DrCampy/FencingTester/Calculs.xlsx

Sheet: Iref_tlc59116
CM | 0
HC | 1
D5 | 1
D4 | 1
D3 | 1
D2 | 0
D1 | 0
D0 | 1
D | 57
VG | 0.9453125
Vout | 1.19109375
Rext | 660
Iref | 1.8046875
Iout, target | 9.0234375

Sheet: ATMega I2C SCL_Freq
Prescaler | 1 |  | CPU_Freq | 16000000
1
4
16 |  |  | SCL_Freq | 98765.4321
64
TWBR0 | 1 | TWBR | 73
TWBR1 | 0
TWBR2 | 0
TWBR3 | 1
TWBR4 | 0
TWBR5 | 0
TWBR6 | 1
TWBR7 | 0
