DrCampy/FencingTester/Illustrator/couvercle.pdf

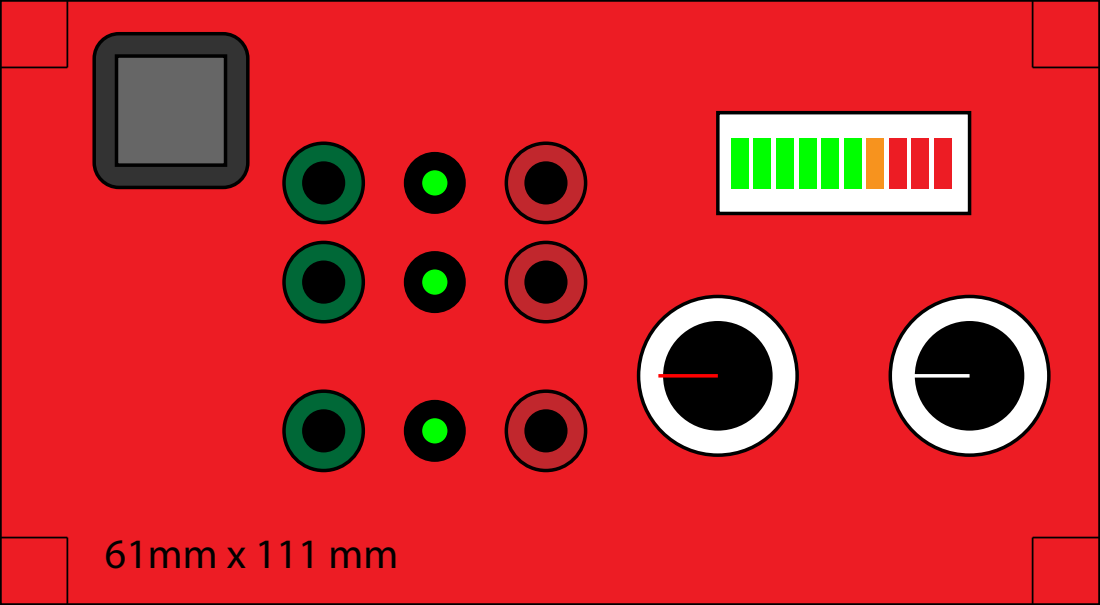
[picture p1: page 1]
