DrCampy/FencingTester/LTSpice - Simulations/alim.asc

C1: cap; 10µ
D1: schottky; MBR0530L
M1: nmos; rq5E035bn
M2: pmos; Si3421DV
R1: res; 10k
R2: res; 2k
R3: res; 5k
V1: voltage; PULSE(0 5 2 0.01 0.01 2 4.02 4)
V2: voltage; 3.2
Named nets: 0
.lib "D:\\Users\\Morgan Diepart\\Documents\\GitHub\\FencingTester\\LTSpice - Simulations\\rq5E035bn.lib"
.lib "D:\\Users\\Morgan Diepart\\Documents\\GitHub\\FencingTester\\LTSpice - Simulations\\Si3421DV_PS.LIB"
.tran 10
