DrCampy/FencingTester/LTSpice - Simulations/bargraph-bjt.asc

D1: LED; NSPW500BS
D2: schottky; MBR0530L
D3: schottky; MBR0530L
D4: schottky; MBR0530L
D5: schottky; MBR0530L
D6: schottky; MBR0530L
D7: schottky; MBR0530L
D8: schottky; MBR0530L
D9: schottky; MBR0530L
D10: schottky; MBR0530L
D11: LED; NSPW500BS
D12: LED; NSPW500BS
D13: LED; NSPW500BS
D14: LED; NSPW500BS
D15: LED; NSPW500BS
D21: LED; NSPW500BS
D22: LED; NSPW500BS
D23: LED; NSPW500BS
D24: LED; NSPW500BS
D25: LED; NSPW500BS
Q1: npn; BC817-25
Q2: npn; BC817-25
Q3: npn; BC817-25
Q4: npn; BC817-25
Q5: npn; BC817-25
Q6: npn; BC817-25
Q7: npn; BC817-25
Q8: npn; BC817-25
Q9: npn; BC817-25
Q10: npn; BC817-25
R1: res; 330
R2: res; 330
R3: res; 330
R4: res; 330
R5: res; 330
R6: res; 330
R7: res; 330
R8: res; 330
R9: res; 330
R10: res; 330
R11: res; 330
V1: voltage; 5
Named nets: 5V, 0
.tran 1
