DrCampy/FencingTester/LTSpice - Simulations/bargraph-mosfet.asc

D21: LED; NSPW500BS
D22: schottky; MBR0530L
D23: LED; NSPW500BS
D24: schottky; MBR0530L
D25: LED; NSPW500BS
D26: schottky; MBR0530L
D27: LED; NSPW500BS
D28: schottky; MBR0530L
D29: LED; NSPW500BS
D30: schottky; MBR0530L
D31: LED; NSPW500BS
D32: schottky; MBR0530L
D33: LED; NSPW500BS
D34: schottky; MBR0530L
D35: LED; NSPW500BS
D36: schottky; MBR0530L
D37: LED; NSPW500BS
D38: schottky; MBR0530L
D39: LED; NSPW500BS
D41: LED; NSPW500BS
M11: nmos; rq5E035bn
M12: nmos; rq5E035bn
M13: nmos; rq5E035bn
M14: nmos; rq5E035bn
M15: nmos; rq5E035bn
M16: nmos; rq5E035bn
M17: nmos; rq5E035bn
M18: nmos; rq5E035bn
M19: nmos; rq5E035bn
M20: nmos; rq5E035bn
R1: res; 20k
R2: res; 20k
R3: res; 20k
R4: res; 20k
R5: res; 20k
R6: res; 20k
R7: res; 20k
R8: res; 20k
R9: res; 20k
R10: res; 20k
R12: res; 330
R13: res; 330
R14: res; 330
R15: res; 330
R16: res; 330
R17: res; 330
R18: res; 330
R19: res; 330
R20: res; 330
R21: res; 330
R22: res; 330
V1: voltage; 4.7
Named nets: 5V, 0
.lib "D:\\Users\\Morgan Diepart\\Documents\\GitHub\\FencingTester\\LTSpice - Simulations\\rq5E035bn.lib"
.tran 15
