DrCampy/FencingTester/KiCad/FencingTester.kicad_pcb

## KiCad design KiCad/FencingTester.kicad_pcb (2019-10-11)

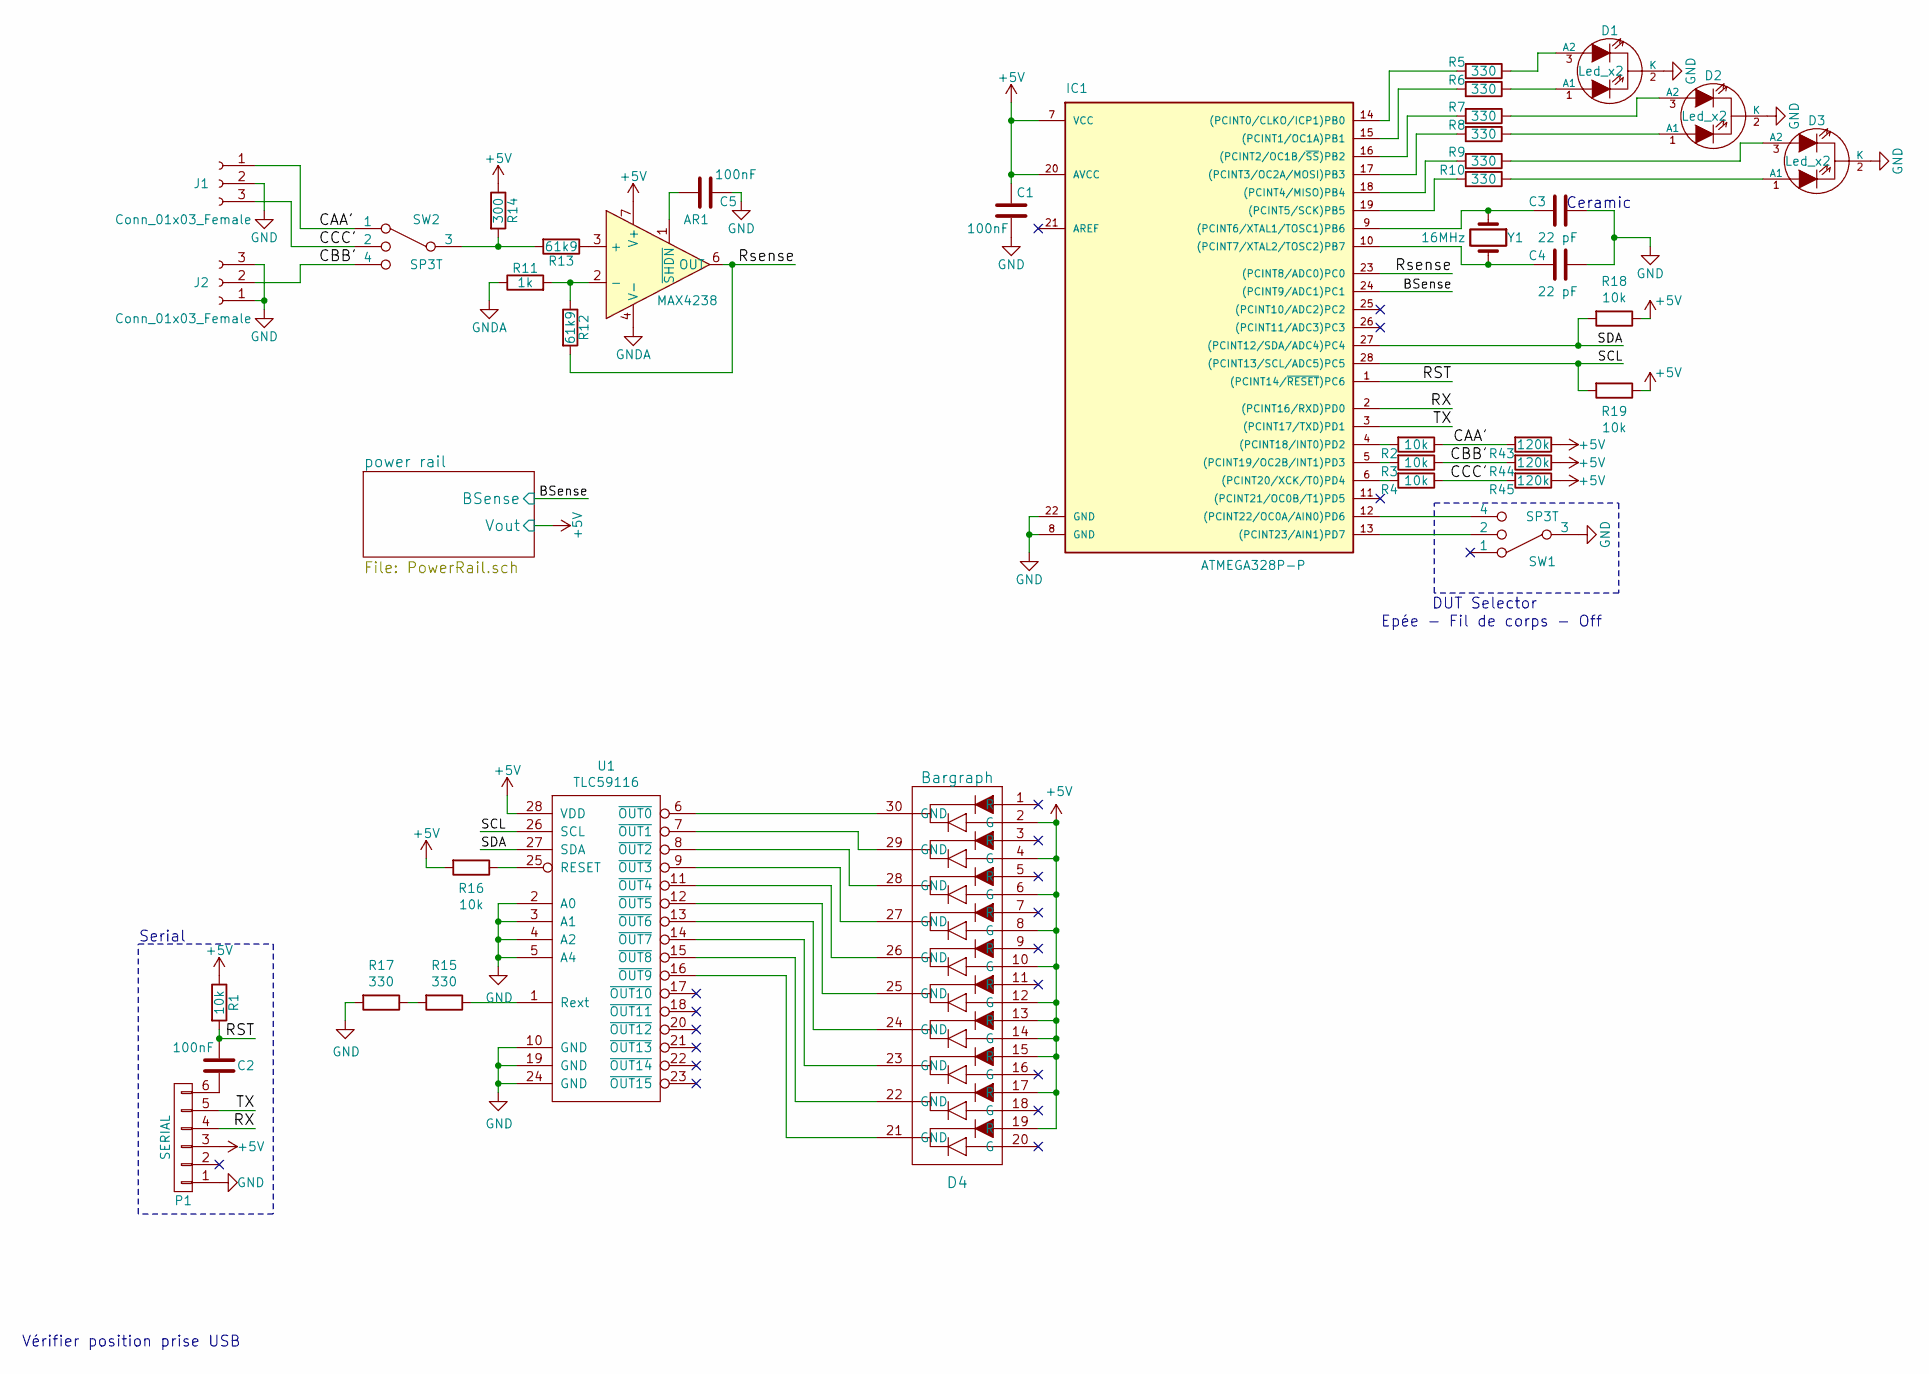
[picture p2: schematic FencingTester.sch, Fencing Tester]

Parts:
AR1: MAX4238; SOIC-8_3.9x4.9mm_P1.27mm
C1, C2, C5: 100nF; C_0805_2012Metric_Pad1.15x1.40mm_HandSolder
C3, C4: 22 pF; C_0805_2012Metric_Pad1.15x1.40mm_HandSolder
D1, D2, D3: Led_x2; 3PadsWires
D4: Bargraph
IC1: ATMEGA328P-P; DIP-28_W7.62mm_Socket_LongPads
J1, J2: Conn_01x03_Female; 3PadsWires
P1: SERIAL; PinHeader_1x06_P2.54mm_Vertical
R1, R2, R3, R4, R16, R18, R19: 10k; R_0805_2012Metric_Pad1.15x1.40mm_HandSolder
R5, R6, R7, R8, R9, R10, R15, R17: 330; R_0805_2012Metric_Pad1.15x1.40mm_HandSolder
R11: 1k; R_0805_2012Metric_Pad1.15x1.40mm_HandSolder
R12, R13: 61k9; R_0805_2012Metric_Pad1.15x1.40mm_HandSolder
R14: 300; R_0805_2012Metric_Pad1.15x1.40mm_HandSolder
R43, R44, R45: 120k; R_0805_2012Metric_Pad1.15x1.40mm_HandSolder
SW1: SP3T; SW1
SW2: SP3T; SW2
U1: TLC59116; TSSOP-28_4.4x9.7mm_P0.65mm
Y1: 16MHz; Quartz

Connections:
+5V: AR1.7 (V+), C1.1, D4.2 (G), D4.4 (G), D4.6 (G), D4.8 (G), D4.10 (G), D4.12 (G), D4.13 (R), D4.14 (G), D4.15 (R), D4.17 (R), D4.19 (R), IC1.7 (VCC), IC1.20 (AVCC), P1.3, R1.1, R14.1, R16.2, R18.1, R19.1, R43.1, R44.1, R45.1, U1.28 (VDD); also elsewhere on the board
/BSense: IC1.24 ((PCINT9/ADC1)PC1); also elsewhere on the board
/CAA': J1.1, R2.1, R43.2, SW2.1
/CBB': J2.2, R3.1, R44.2, SW2.4
/CCC': J1.3, R4.1, R45.2, SW2.2
/RST: C2.2, IC1.1 ((PCINT14/~RESET~)PC6), R1.2
/RX: IC1.2 ((PCINT16/RXD)PD0), P1.4
/Rsense: AR1.6 (OUT), IC1.23 ((PCINT8/ADC0)PC0), R12.2
/SCL: IC1.28 ((PCINT13/SCL/ADC5)PC5), R19.2, U1.26 (SCL)
/SDA: IC1.27 ((PCINT12/SDA/ADC4)PC4), R18.2, U1.27 (SDA)
/TX: IC1.3 ((PCINT17/TXD)PD1), P1.5
GND: C1.2, C3.2, C4.2, C5.1, D1.2 (K), D2.2 (K), D3.2 (K), IC1.8 (GND), IC1.22 (GND), J1.2, J2.1, J2.3, P1.1, R17.2, SW1.3, U1.2 (A0), U1.3 (A1), U1.4 (A2), U1.5 (A4), U1.10 (GND), U1.19 (GND), U1.24 (GND); also elsewhere on the board
GNDA: AR1.4 (V-), R11.1; also elsewhere on the board
unnamed: AR1.1 (~SHDN), C5.2
unnamed: AR1.2 (-), R11.2, R12.1
unnamed: AR1.3 (+), R13.1
unnamed: C2.1, P1.6
unnamed: C3.1, IC1.9 ((PCINT6/XTAL1/TOSC1)PB6), Y1.1
unnamed: C4.1, IC1.10 ((PCINT7/XTAL2/TOSC2)PB7), Y1.2
unnamed: D1.1 (A1), R6.1
unnamed: D1.3 (A2), R5.1
unnamed: D2.1 (A1), R8.1
unnamed: D2.3 (A2), R7.1
unnamed: D3.1 (A1), R10.1
unnamed: D3.3 (A2), R9.1
unnamed: D4.21 (GND), U1.16 (~OUT9)
unnamed: D4.22 (GND), U1.15 (~OUT8)
unnamed: D4.23 (GND), U1.14 (~OUT7)
unnamed: D4.24 (GND), U1.13 (~OUT6)
unnamed: D4.25 (GND), U1.12 (~OUT5)
unnamed: D4.26 (GND), U1.11 (~OUT4)
unnamed: D4.27 (GND), U1.9 (~OUT3)
unnamed: D4.28 (GND), U1.8 (~OUT2)
unnamed: D4.29 (GND), U1.7 (~OUT1)
unnamed: D4.30 (GND), U1.6 (~OUT0)
unnamed: IC1.4 ((PCINT18/INT0)PD2), R2.2
unnamed: IC1.5 ((PCINT19/OC2B/INT1)PD3), R3.2
unnamed: IC1.6 ((PCINT20/XCK/T0)PD4), R4.2
unnamed: IC1.12 ((PCINT22/OC0A/AIN0)PD6), SW1.4
unnamed: IC1.13 ((PCINT23/AIN1)PD7), SW1.2
unnamed: IC1.14 ((PCINT0/CLKO/ICP1)PB0), R5.2
unnamed: IC1.15 ((PCINT1/OC1A)PB1), R6.2
unnamed: IC1.16 ((PCINT2/OC1B/~SS~)PB2), R7.2
unnamed: IC1.17 ((PCINT3/OC2A/MOSI)PB3), R8.2
unnamed: IC1.18 ((PCINT4/MISO)PB4), R9.2
unnamed: IC1.19 ((PCINT5/SCK)PB5), R10.2
unnamed: R13.2, R14.2, SW2.3
unnamed: R15.1, U1.1 (Rext)
unnamed: R15.2, R17.1
unnamed: R16.1, U1.25 (RESET)

Notes on the sheet:
Ceramic
Serial
DUT Selector
Epée - Fil de corps - Off
Vérifier position prise USB

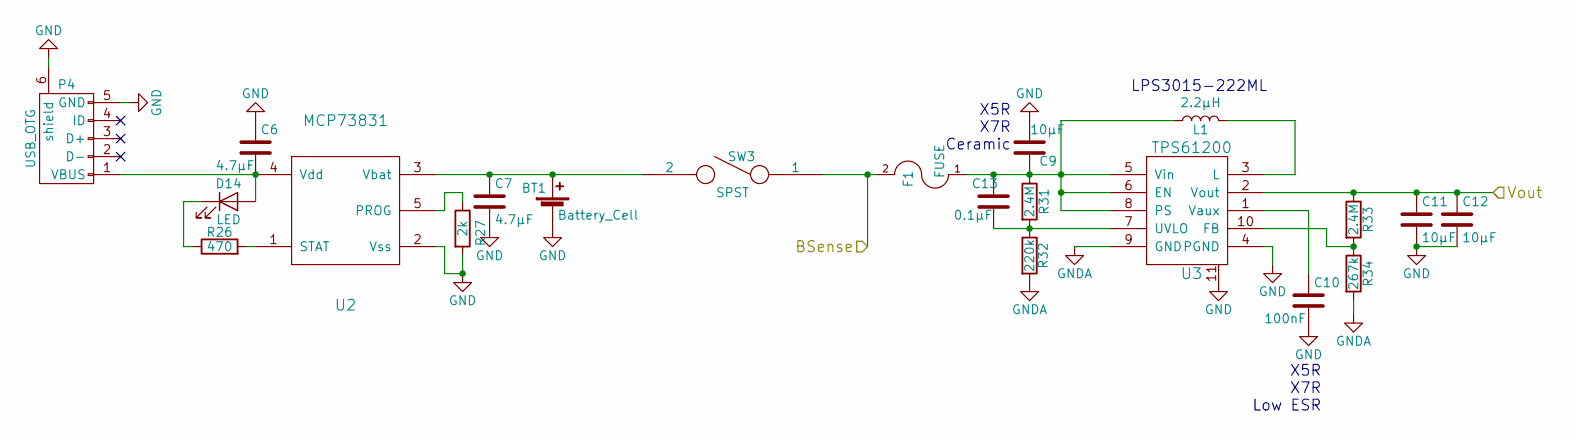
[picture p3: schematic PowerRail.sch, Fencing Tester]

Parts:
BT1: Battery_Cell; 2PadsWire
C6, C7: 4.7µF; C_0805_2012Metric_Pad1.15x1.40mm_HandSolder
C9, C11, C12: 10µF; C_0805_2012Metric_Pad1.15x1.40mm_HandSolder
C10: 100nF; C_0805_2012Metric_Pad1.15x1.40mm_HandSolder
C13: 0.1µF; C_0805_2012Metric_Pad1.15x1.40mm_HandSolder
D14: LED; ChargingLed
F1: FUSE; Fuse_1206_3216Metric_Pad1.42x1.75mm_HandSolder
L1: 2.2µH; CoilCraft-LPS3015-CMS
P4: USB_OTG; USB_Micro-B
R26: 470; R_0805_2012Metric_Pad1.15x1.40mm_HandSolder
R27: 2k; R_0805_2012Metric_Pad1.15x1.40mm_HandSolder
R31, R33: 2.4M; R_0805_2012Metric_Pad1.15x1.40mm_HandSolder
R32: 220k; R_0805_2012Metric_Pad1.15x1.40mm_HandSolder
R34: 267k; R_0805_2012Metric_Pad1.15x1.40mm_HandSolder
SW3: SPST; SW3
U2: MCP73831; TSOT-23-5_HandSoldering
U3: TPS61200

Connections:
+5V: C11.1, C12.1, R33.1, U3.2 (Vout); also elsewhere on the board
/BSense: F1.2, SW3.1; also elsewhere on the board
GND: BT1.2 (-), C6.1, C7.2, C9.1, C10.2, C11.2, C12.2, P4.5 (GND), P4.6 (shield), R27.2, U2.2 (Vss), U3.4 (PGND), U3.11; also elsewhere on the board
GNDA: R32.2, R34.2, U3.9 (GND); also elsewhere on the board
unnamed: BT1.1 (+), C7.1, SW3.2, U2.3 (Vbat)
unnamed: C6.2, D14.2 (A), P4.1 (VBUS), U2.4 (Vdd)
unnamed: C10.1, U3.1 (Vaux)
unnamed: C9.2, C13.1, F1.1, L1.1, R31.1, U3.5 (Vin), U3.6 (EN), U3.8 (PS)
unnamed: C13.2, R31.2, R32.1, U3.7 (UVLO)
unnamed: D14.1 (K), R26.1
unnamed: L1.2, U3.3 (L)
unnamed: R26.2, U2.1 (STAT)
unnamed: R27.1, U2.5 (PROG)
unnamed: R33.2, R34.1, U3.10 (FB)

Notes on the sheet:
X5R X7R Ceramic
X5R X7R Low ESR
LPS3015-222ML

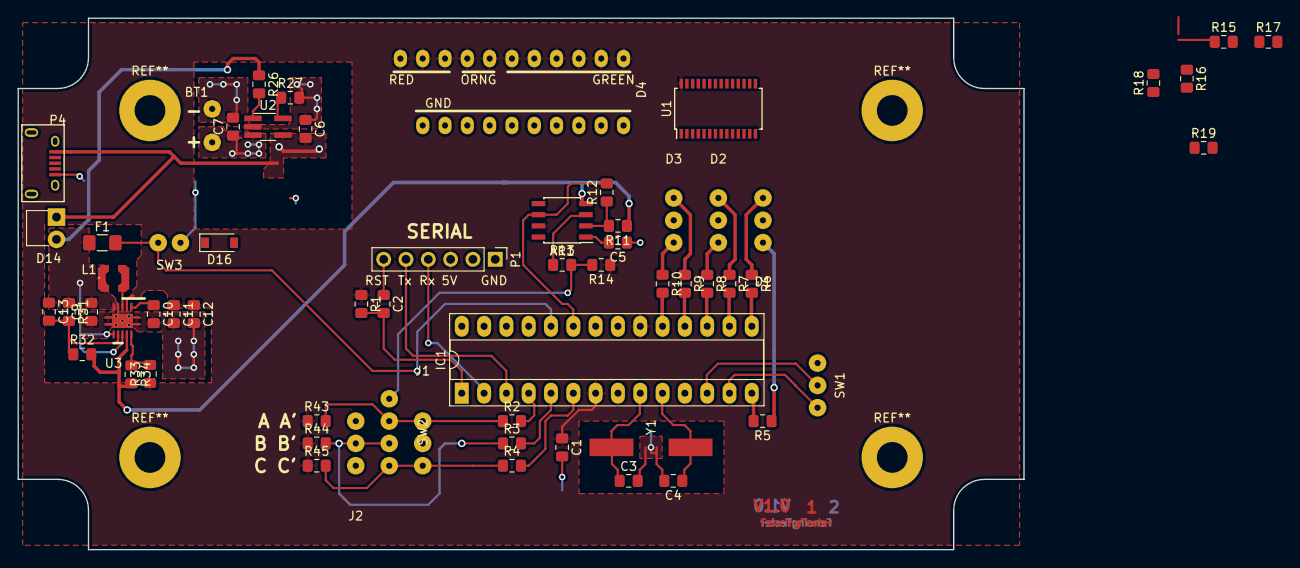
[picture p4: board FencingTester.kicad_pcb from above]

Board: 2 copper layers, 114.5 x 60.5 mm, 62 parts (0 on the bottom side), 60 nets.

Other parts of the board:
D16: D_Schottky; SOD-123
