DrCampy/FencingTester/Code/Atmel Studio/FencingTesterFirmware/FencingTester/timers.h

#ifndef TIMERS_H
#define TIMERS_H

#include <avr/io.h>

void set_timer0();
void enable_timer0();
void disable_timer0();

void set_timer1();
void enable_timer1();
void disable_timer1();

void set_timer2();
void enable_timer2();
void disable_timer2();


#endif
