DrCampy/FencingTester/(commit log)

2018-09-04 Project import
    Importing project from Dropbox
    [BargraphDriver.sch, Calculs résistances.xlsx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]
2018-09-04 Import
    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
    [BargraphDriver.sch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]
2018-09-08 General update
    Upgrading Kicad Project to V5.0.0
    Deleting old files
    [BargraphDriver-2018-09-08-16-52-57.sch, FencingTester-2018-09-08-16-52-57.sch, FencingTester.kicad_pcb, PowerRail-2018-09-08-16-52-57.sch]
2018-09-08 Deleting duplicate kicad folder
    [BargraphDriver.sch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]
2018-09-11 Schottky diode Datasheet
2018-09-15 New Mosfet designe Bargraph driver
    [BargraphDriver.sch]
2018-09-15 Bargraph driver - Mosfet
    [BargraphDriver.sch]
2018-09-20 Finishing MOSFET implementation on Bargraph driver
    Swithcing from BJT to mosfet. Simplifying the use of diodes
    [BargraphDriver.sch]
2018-09-20 New PCB Layout
    New pcb layout for the bargraph driver part
    [FencingTester.sch]
2018-10-09 Wiring PCB
    [FencingTester.kicad_pcb]
2018-10-27 Sheet bargraph driver marked unused
    [BargraphDriver.sch]
2018-10-27 Simplifying power rail
    We do not switch to USB power anymore when USB is connected
    [PowerRail.sch]
2018-10-27 New bargraph driver + General cleanup
    [FencingTester.sch]
2018-10-27 kicad project edits
2018-10-27 Importing new netlist
    [FencingTester.kicad_pcb]
2018-10-27 Notes on how to use I2C with atmega
2018-10-27 kicad files
2018-10-27 More notes on I2C
2018-11-01 Finishing bargraph init
    [calcul_iref_tlc59116.xlsx]
2018-11-06 Calculs I2C SCL_Freq
    [Calculs.xlsx, calcul_iref_tlc59116.xlsx]
2018-11-07 Bargraph::setValue coding using I2C
2018-11-07 Update Schematic
    [FencingTester.sch]
2018-11-07 Update PCB
    [FencingTester.kicad_pcb]
2018-11-07 Delete (Copie en conflit de DESKTOP-UJQC2R6 2017-02-15).atsuo
    unnecessary file
2019-09-30 Updating modules libraries
    [FencingTester.kicad_pcb, FencingTester.sch, PowerRail.sch]
2019-10-01 PCB advancements
    [FencingTester.kicad_pcb]
2019-10-11 [WIP] PCB layout
    [FencingTester.kicad_pcb]
